ananyakmehta/TrafficEnforcer/README.md

# Traffic Enforcer
    # An automotive system that automatically enforces special driving zone requirements like speed, noise, and light levels.
